Gastd/carro_pcb/Placas/PCB Slave MMR1/Placa controladora carro mym.brd

## EAGLE design Placas/PCB Slave MMR1/Placa controladora carro mym.brd (2019-01-18)

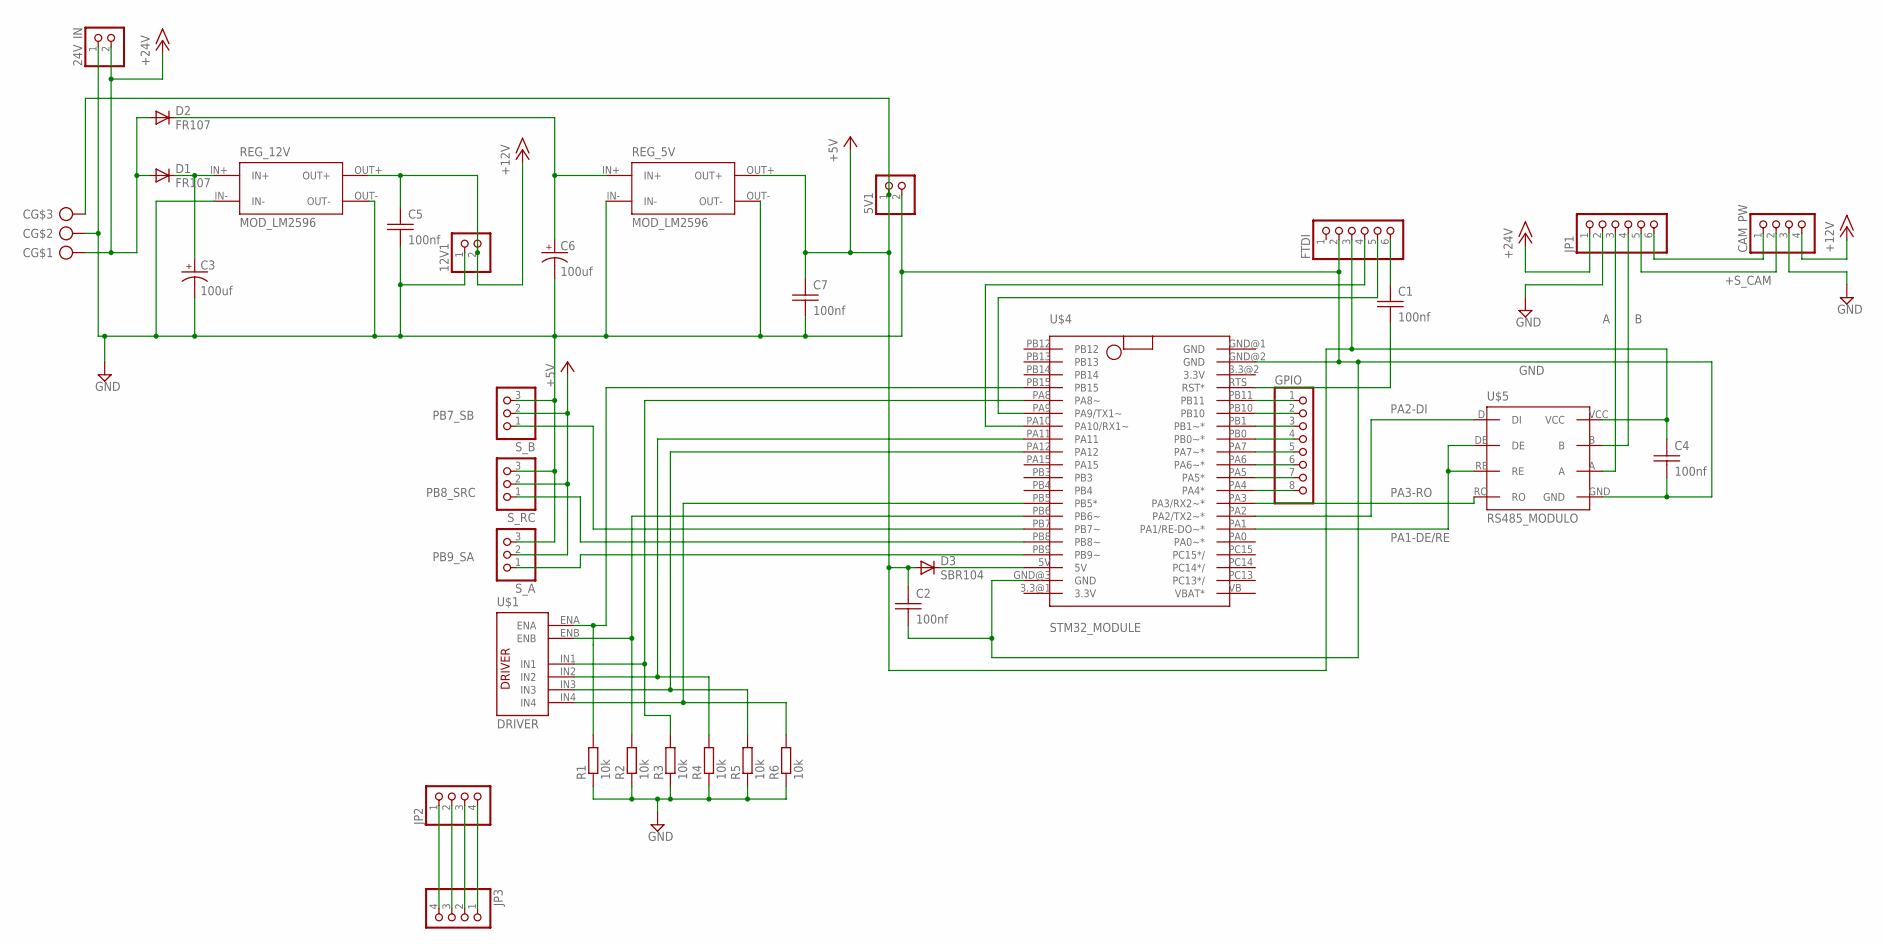
[picture p1: schematic Placa controladora carro mym.sch]

Parts:
5V1, 12V1, 24V_IN: PINHD-1X2; 1X02
C: drv; PTR_AK300/3
C1, C2, C4, C5, C7: 100nf; CAP_CER_2,54-5X5
C3, C6: 100uf; CAP_T_5-D8,5
CAM_PW: PINHD-1X4; 1X04
D1, D2: FR107; D-2.5
D3: SBR104; D_SMD
FTDI: PINHD-1X6; 1X06
GPIO: PINHD-1X8; 1X08
JP1: PINHD-1X6; 1X06
JP2, JP3: PINHD-1X4; 1X04
R1, R2, R3, R4, R5, R6: 10k; 0204/7
REG_5V, REG_12V: MOD_LM2596; MOD_LM2596_FP
S_A: PINHD-1X3; 1X03
S_B: PINHD-1X3; 1X03
S_RC: PINHD-1X3; 1X03
U$1: DRIVER
U$4: STM32_MODULE; STM32FP
U$5: RS485_MODULO; RS485_FP

Connections:
+5V: 5V1.1, C.3, C2.1, C4.1, C7.1, D3.A, FTDI.3, REG_5V.OUT+, S_A.2, S_B.2, S_RC.2, U$5.VCC
+12V: 12V1.2, C5.1, REG_12V.OUT+
+15V: 24V_IN.2, C.1, CAM_PW.4, D1.A, D2.A, JP1.1
+S_CAM: CAM_PW.2, JP1.5
A: JP1.3, U$5.A
B: JP1.4, U$5.B
ENA: R1.2, U$1.ENA, U$4.PB15
ENEB: R2.2, U$1.ENB, U$4.PB6 (PB6~)
GND: 5V1.2, 12V1.1, 24V_IN.1, C.2, C2.2, C3.-, C4.2, C5.2, C6.-, C7.2, CAM_PW.3, FTDI.2, JP1.2, R1.1, R2.1, R3.1, R4.1, R5.1, R6.1, REG_5V.IN-, REG_5V.OUT-, REG_12V.IN-, REG_12V.OUT-, S_A.3, S_B.3, S_RC.3, U$4.GND@2 (GND), U$4.GND@3 (GND), U$5.GND
IN1: R3.2, U$1.IN1, U$4.PA8 (PA8~)
IN2: R4.2, U$1.IN2, U$4.PA11
IN3: R5.2, U$1.IN3, U$4.PA12
IN4: R6.2, U$1.IN4, U$4.PB5 (PB5*)
unnamed: D3.K (C), U$4.5V
unnamed: C6.+, D2.C, REG_5V.IN+
unnamed: C3.+, D1.C, REG_12V.IN+
unnamed: CAM_PW.1, JP1.6
unnamed: JP2.1, JP3.4
unnamed: FTDI.4, U$4.PA10 (PA10/RX1~)
unnamed: FTDI.5, U$4.PA9 (PA9/TX1~)
unnamed: C1.1, FTDI.6
unnamed: C1.2, U$4.RTS (RST*)
unnamed: JP2.2, JP3.3
unnamed: JP2.3, JP3.2
unnamed: JP2.4, JP3.1
unnamed: GPIO.1, U$4.PB11
unnamed: GPIO.2, U$4.PB10
unnamed: GPIO.3, U$4.PB1 (PB1~*)
unnamed: GPIO.4, U$4.PB0 (PB0~*)
unnamed: GPIO.5, U$4.PA7 (PA7~*)
unnamed: GPIO.6, U$4.PA6 (PA6~*)
unnamed: GPIO.7, U$4.PA5 (PA5*)
unnamed: GPIO.8, U$4.PA4 (PA4*)
PA1-DE/RE: U$4.PA1 (PA1/RE-DO~*), U$5.DE, U$5.RE
PA2-DI: U$4.PA2 (PA2/TX2~*), U$5.DI
PA3-RO: U$4.PA3 (PA3/RX2~*), U$5.RO
PB7_SB: S_B.1, U$4.PB7 (PB7~)
PB8_SRC: S_RC.1, U$4.PB8 (PB8~)
PB9_SA: S_A.1, U$4.PB9 (PB9~)

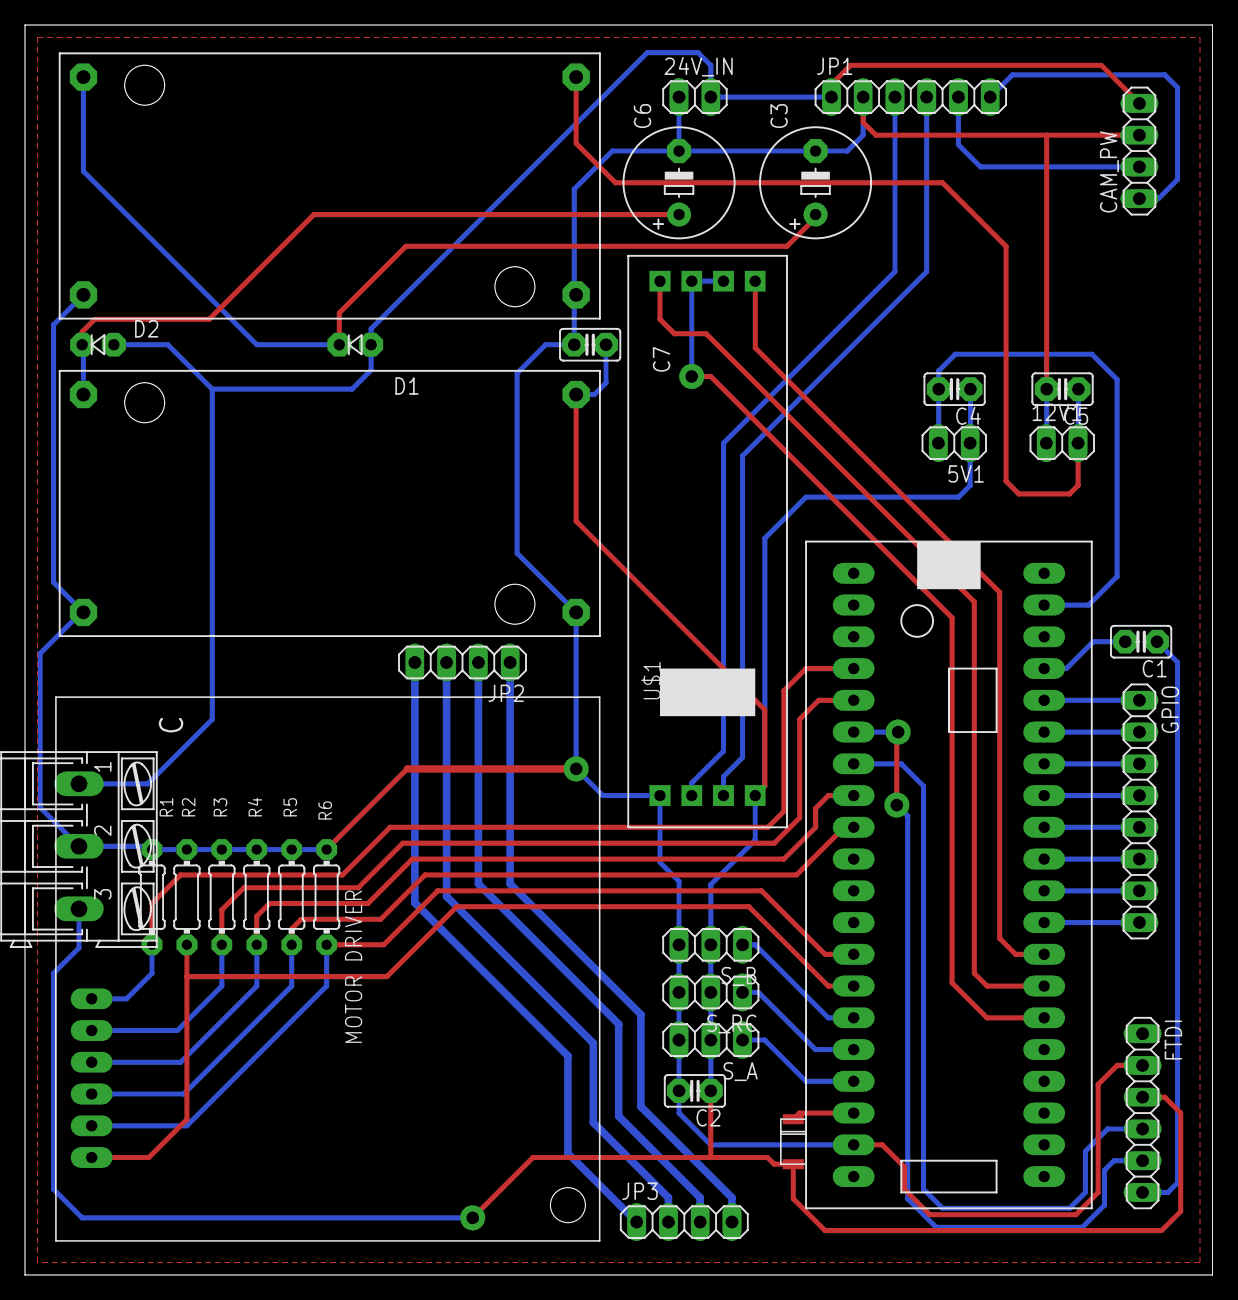
[picture p2: board Placa controladora carro mym.brd from above]

Board: 2 copper layers, 95.0 x 100.0 mm, 34 parts (0 on the bottom side), 39 nets.
