Gastd/carro_pcb/Placas/PCB Master MMR1/PCB_MASTER_CARRO_MYM.brd

## EAGLE design Placas/PCB Master MMR1/PCB_MASTER_CARRO_MYM.brd (2019-01-18)

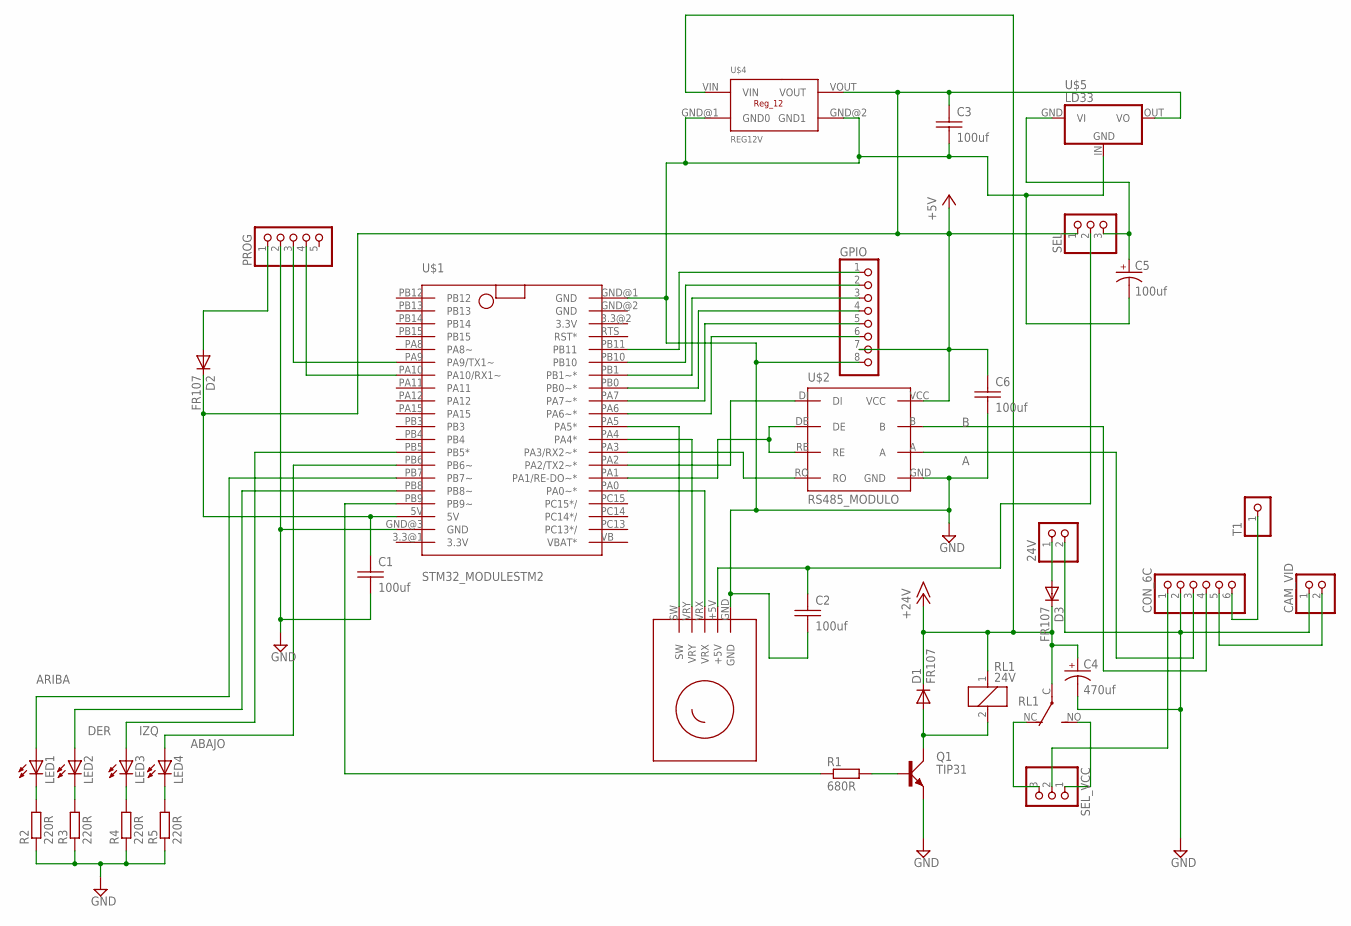
[picture p3: schematic PCB_MASTER_CARRO_MYM.sch]

Parts:
24V: PINHD-1X2; 1X02
C1, C2, C3, C6: 100uf; CAP_CER_2,54-5X5
C4: 470uf; CAP_T_5-D8,5
C5: 100uf; CAP_T_3,5-D8
CAM_VID: PINHD-1X2; 1X02
CON_6C: PINHD-1X6; 1X06
D1: FR107; D-5
D2, D3: FR107; DIODO4MM
GPIO: PINHD-1X8; 1X08
LED1, LED2, LED3, LED4: LEDLED_T_3MM; LED3MM
PROG: PINHD-1X5; 1X05
Q1: TIP31; TO220
R1: 680R; 0204/5
R2, R3, R4, R5: 220R; 0204/5
RL1: 24V; CQ1
SEL: PINHD-1X3; 1X03
SEL_VCC: PINHD-1X3; 1X03
T1: PINHD-1X1; 1X01
U$1: STM32_MODULESTM2; STM_32MOD
U$2: RS485_MODULO; RS485_FP
U$3: JOYSTICK
U$4: REG12V
U$5: LD33; 78XXS

Connections:
+5V: C1.1, C3.1, C6.1, D2.C, GPIO.7, SEL.1, U$1.5V, U$2.VCC, U$4.VOUT, U$5.OUT (VO)
+15V: C4.+, D1.C, D3.C, RL1.1, RL1.C, U$4.VIN
A: CON_6C.3, U$2.A
ABAJO: LED4.A, U$1.PB6 (PB6~)
ARIBA: LED1.A, U$1.PB7 (PB7~)
B: CON_6C.4, U$2.B
DER: LED2.A, U$1.PB8 (PB8~)
GND: 24V.2, C1.2, C2.2, C3.2, C4.-, C5.-, C6.2, CAM_VID.1, CON_6C.2, GPIO.8, PROG.2, Q1.E, R2.1, R3.1, R4.1, R5.1, U$1.GND@1 (GND), U$1.GND@3 (GND), U$2.GND, U$3.GND, U$4.GND@1 (GND0), U$4.GND@2 (GND1), U$5.IN (GND)
IZQ: LED3.A, U$1.PB5 (PB5*)
unnamed: C5.+, SEL.3, U$5.GND (VI)
unnamed: LED1.K (C), R2.2
unnamed: LED2.K (C), R3.2
unnamed: LED3.K (C), R4.2
unnamed: LED4.K (C), R5.2
unnamed: 24V.1, D3.A
unnamed: U$1.PA1 (PA1/RE-DO~*), U$2.DE, U$2.RE
unnamed: U$1.PA2 (PA2/TX2~*), U$2.DI
unnamed: U$1.PA3 (PA3/RX2~*), U$2.RO
unnamed: D1.A, Q1.C, RL1.2
unnamed: C2.1, SEL.2, U$3.+5V
unnamed: Q1.B, R1.2
unnamed: R1.1, U$1.PB9 (PB9~)
unnamed: RL1.NC (O), SEL_VCC.3
unnamed: CAM_VID.2, CON_6C.5
unnamed: RL1.NO (S), SEL_VCC.1
unnamed: CON_6C.1, SEL_VCC.2
unnamed: GPIO.6, U$1.PA6 (PA6~*)
unnamed: GPIO.5, U$1.PA7 (PA7~*)
unnamed: GPIO.4, U$1.PB0 (PB0~*)
unnamed: GPIO.3, U$1.PB1 (PB1~*)
unnamed: GPIO.2, U$1.PB10
unnamed: GPIO.1, U$1.PB11
unnamed: D2.A, PROG.1
unnamed: CON_6C.6, T1.1
RX-TX_A9: PROG.3, U$1.PA9 (PA9/TX1~)
SW: U$1.PA0 (PA0~*), U$3.VRX
TX-RX_A10: PROG.4, U$1.PA10 (PA10/RX1~)
VRX: U$1.PA5 (PA5*), U$3.SW
VRY: U$1.PA4 (PA4*), U$3.VRY

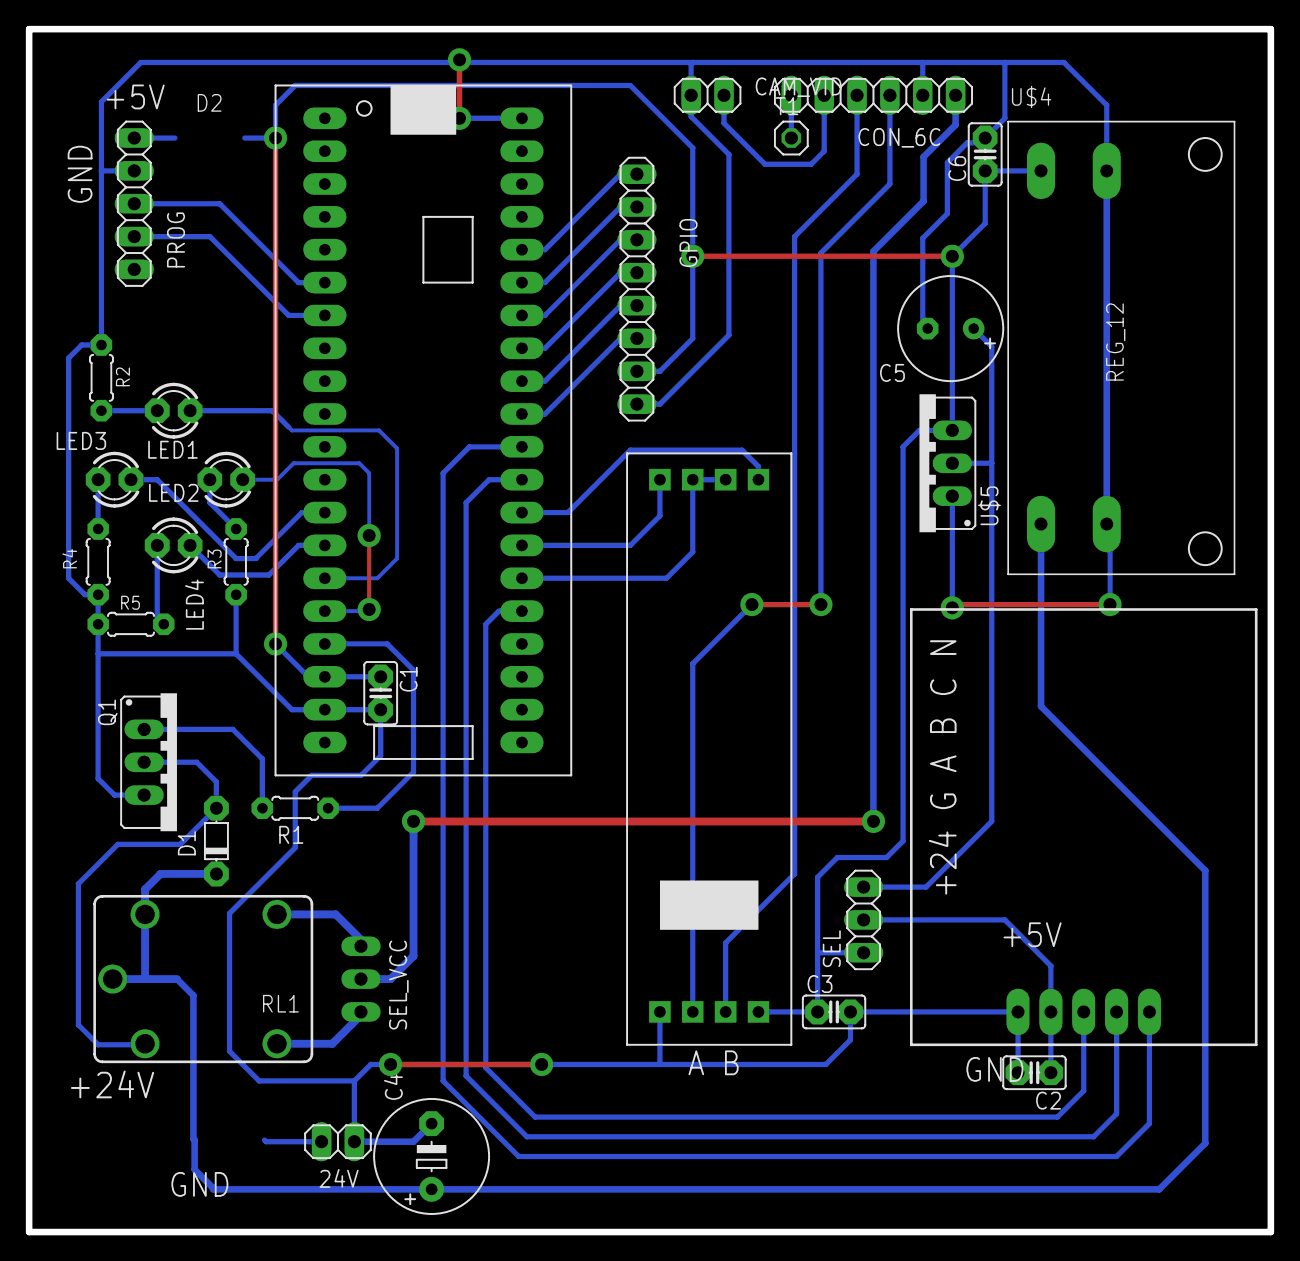
[picture p4: board PCB_MASTER_CARRO_MYM.brd from above]

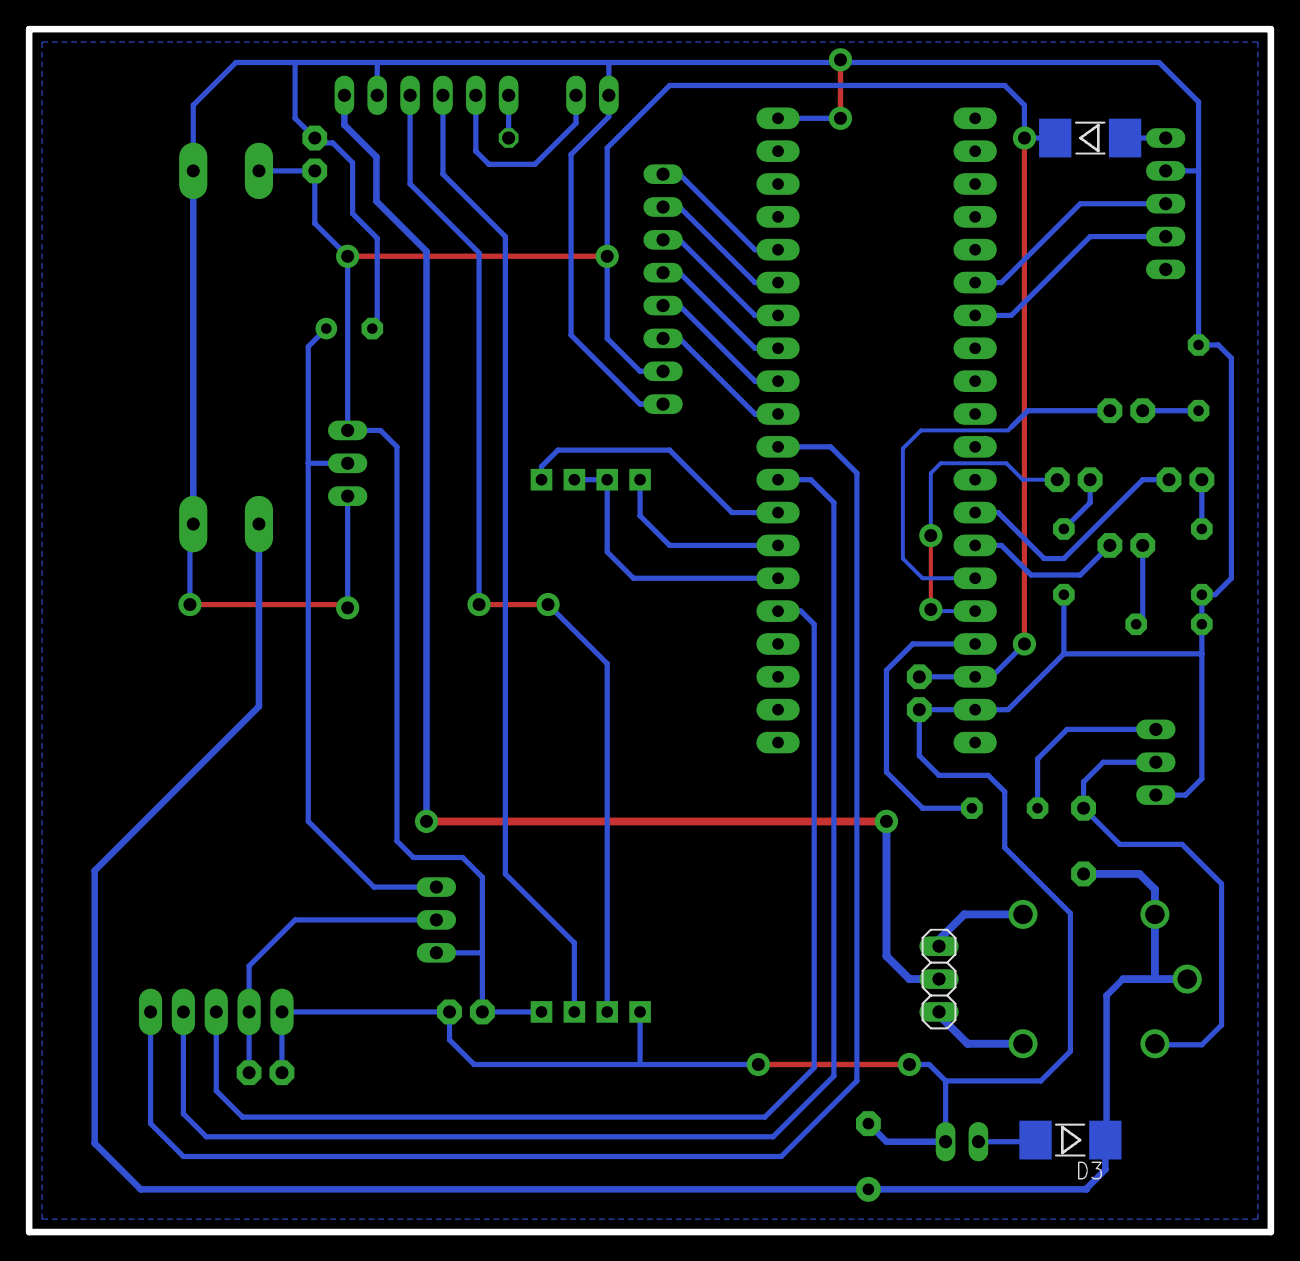
[picture p5: board PCB_MASTER_CARRO_MYM.brd from below]

Board: 2 copper layers, 96.0 x 93.0 mm, 33 parts (3 on the bottom side), 39 nets.
