Gastd/carro_pcb/(commit log)

2018-09-08 Add library arduino nano
2018-09-08 Add arduino code
2019-01-18 Colocando todo junto
    plascas y codigo en arduino
    [untitled.brd, untitled.sch]
2019-01-18 Version 1 funcionando
    placas e inos, falta colocar isolamento de USB
    [PCB_MASTER_CARRO_MYM.brd, PCB_MASTER_CARRO_MYM.sch, Placa controladora carro mym.brd, Placa controladora carro mym.sch]
2019-01-18 joystick funcionando
    adicionado el control por joystick
    [Placa controladora carro mym.brd, Placa controladora carro mym.sch]
